l3wi/IWR-AOP-MODULE/manufacturing/jlcpcb/bom-source.csv

Comment | Designator | Footprint | LCSC | Qty | MPN | Manufacturer | Tolerance | Rating
0R | R314,R604 | Resistor_SMD:R_0402_1005Metric | C17168 | 2 | 0402WGF0000TCE | UNI-ROYAL(Uniroyal Elec)
18pF | C346,C347 | Capacitor_SMD:C_0402_1005Metric | C1549 | 2 | 0402CG180J500NT | FH (Guangdong Fenghua Advanced Tech)
390pF | C614,C615,C616,C617 | Capacitor_SMD:C_0402_1005Metric | C76967 | 4 | GRM1555C1H391JA01D | Murata Electronics | 5% | C0G 50V
47nF | C345 | Capacitor_SMD:C_0402_1005Metric | C77017 | 1 | GRM155R71E473KA88D | Murata
100nF | C301,C302,C303,C304,C305,C306,C307,C308,C309,C310,C311,C314,C315,C316,C317,C318,C319,C322,C323,C324,C325,C326,C327,C328,C329,C330,C331,C332,C333,C335,C336,C338,C340,C342,C343,C344,C348,C604,C622,C623,C706 | Capacitor_SMD:C_0402_1005Metric | C1525 | 41 | CL05B104KO5NNNC | Samsung Electro-Mechanics
0.47uH | L600,L601,L602,L603 | Inductor_SMD:L_Sunlord_MWSA0402S | C6331050 | 4 | MWSA0402S-R47MT | Sunlord
1uF | C313,C321,C337,C339 | Capacitor_SMD:C_0603_1608Metric | C15849 | 4 | CL10A105KB8NNNC | Samsung Electro-Mechanics
4.7uF | C341 | Capacitor_SMD:C_0603_1608Metric | C19666 | 1 | CL10A475KO8NNNC | Samsung Electro-Mechanics
10uF | C300,C312,C320,C334 | Capacitor_SMD:C_0805_2012Metric | C15850 | 4 | CL21A106KAYNNNE | Samsung Electro-Mechanics
10uF | C620,C621,C629 | Capacitor_SMD:C_0805_2012Metric | C86038 | 3 | GRM21BR71A106KE51L | Murata Electronics | 10% | X7R 10V
22uF | C600,C601,C602,C603,C610,C611,C612,C613 | Capacitor_SMD:C_1210_3225Metric | C21397 | 8 | GRM32ER71E226KE15L | Murata Electronics | 10% | X7R 25V
22uF | C624,C625 | Capacitor_SMD:C_0805_2012Metric | C45783 | 2 | CL21A226MAQNNNE | Samsung Electro-Mechanics | 20% | X5R 25V
1kR | R208,R410,R417 | Resistor_SMD:R_0402_1005Metric | C11702 | 3 | 0402WGF1001TCE | UNI-ROYAL(Uniroyal Elec)
3.9R | R610,R611,R612,R613 | Resistor_SMD:R_0603_1608Metric | C482845 | 4 | RC0603FR-073R9L | YAGEO | 1% | 100mW
4.7kR | R202 | Resistor_SMD:R_0402_1005Metric | C25900 | 1 | 0402WGF4701TCE | UNI-ROYAL(Uniroyal Elec)
10kR | R133,R300,R304,R305,R306,R307,R308,R309,R310,R311,R312,R313,R404,R413,R416,R600,R601,R602,R603 | Resistor_SMD:R_0402_1005Metric | C25744 | 19 | 0402WGF1002TCE | UNI-ROYAL(Uniroyal Elec)
22R | R407,R408,R409,R415 | Resistor_SMD:R_0402_1005Metric | C25092 | 4 | 0402WGF220JTCE | UNI-ROYAL(Uniroyal Elec)
24kR | R200 | Resistor_SMD:R_0402_1005Metric | C25769 | 1 | 0402WGF2402TCE | UNI-ROYAL(Uniroyal Elec)
47kR | R201 | Resistor_SMD:R_0402_1005Metric | C25792 | 1 | 0402WGF4702TCE | UNI-ROYAL(Uniroyal Elec)
100R | R209 | Resistor_SMD:R_0402_1005Metric | C25076 | 1 | 0402WGF1000TCE | UNI-ROYAL(Uniroyal Elec)
100kR | R205,R206,R402,R403,R414 | Resistor_SMD:R_0402_1005Metric | C25741 | 5 | 0402WGF1003TCE | UNI-ROYAL(Uniroyal Elec)
40MHz | Y300 | Crystal:Crystal_SMD_3225-4Pin_3.2x2.5mm | C18214314 | 1 | XL2EL89COI-111YLC-40M | YXC Crystal Oscillators
100nF 16V | C201 | Capacitor_SMD:C_0402_1005Metric | C1525 | 1 | CL05B104KO5NNNC | Samsung Electro-Mechanics
10uF 10V | C140 | Capacitor_SMD:C_0805_2012Metric | C86038 | 1 | GRM21BR71A106KE51L | Murata Electronics
120R@100MHz / 3A | FB600,FB601 | Inductor_SMD:L_0603_1608Metric | C437404 | 2 | BLM18KG121TH1D | Murata
1uF 25V | C100,C202 | Capacitor_SMD:C_0805_2012Metric | C28323 | 2 | CL21B105KBFNNNE | Samsung Electro-Mechanics
3A 32V 0467003.NRHF | F200 | Fuse:Fuse_0603_1608Metric | C99558 | 1 | 0467003.NRHF | Littelfuse
4.7uF 16V | C200,C203 | Capacitor_SMD:C_0805_2012Metric | C1779 | 2 | CL21A475KAQNNNE | Samsung Electro-Mechanics
5.1kR 1% | R100,R101 | Resistor_SMD:R_0402_1005Metric | C25905 | 2 | 0402WGF5101TCE | UNI-ROYAL(Uniroyal Elec)
BOOT | SW401 | IWR-AOP-MODULE:XKB_TS-1187A-B-A-B_5.1x5.1mm | C318884 | 1 | TS-1187A-B-A-B | XKB Connection
CP2105-F01-GMR | U200 | Package_DFN_QFN:QFN-24-1EP_4x4mm_P0.5mm_EP2.7x2.6mm | C109102 | 1 | CP2105-F01-GMR | Silicon Laboratories
H5VUT2U | D200,D201 | Package_TO_SOT_SMD:SOT-23 | C20615824 | 2 | H5VUT2U | hongjiacheng
IWR6843ARQGALPR | U300 | IWR-AOP-MODULE:BGA180C80P18X18_1500X1500X97N | C2871887 | 1 | IWR6843ARQGALPR | Texas Instruments
LM66200DRLR | U117 | Package_TO_SOT_SMD:SOT-583-8 | C3235556 | 1 | LM66200DRLR | Texas Instruments
LP87524JRNFRQ1 | U600 | IWR-AOP-MODULE:Texas_RNF0026C_LP87524J | C701982 | 1 | LP87524JRNFRQ1 | Texas Instruments
MMBT3904 | Q402 | Package_TO_SOT_SMD:SOT-23 | C20526 | 1 | MMBT3904 | Jiangsu Changjing Electronics Technology Co., Ltd.
MX25L3233FM2I-08G | U301 | Package_SO:SOIC-8_5.3x5.3mm_P1.27mm | C190802 | 1 | MX25L3233FM2I-08G | Macronix
RADAR JTAG | J301 | IWR-AOP-MODULE:XKB_X1270WVS-2x05B-9TV01_2x05_P1.27mm_Vertical | C2962219 | 1 | X1270WVS-2x05B-9TV01 | XKB Connection
RESET | SW400 | IWR-AOP-MODULE:XKB_TS-1187A-B-A-B_5.1x5.1mm | C318884 | 1 | TS-1187A-B-A-B | XKB Connection
SPI / DATA | J401 | IWR-AOP-MODULE:HCTL_PM254-2-05-S-8.5 | C3975150 | 1 | PM254-2-05-S-8.5 | HCTL
UART / CONTROL / 5V IN | J400 | IWR-AOP-MODULE:HCTL_PM254-2-06-S-8.5 | C3975151 | 1 | PM254-2-06-S-8.5 | HCTL
USB4105-GF-A | J200 | Connector_USB:USB_C_Receptacle_GCT_USB4105-xx-A_16P_TopMnt_Horizontal | C3020560 | 1 | USB4105-GF-A | Global Connector Technology
