l3wi/IWR-AOP-MODULE/docs/3d/IWR-AOP-MODULE.step

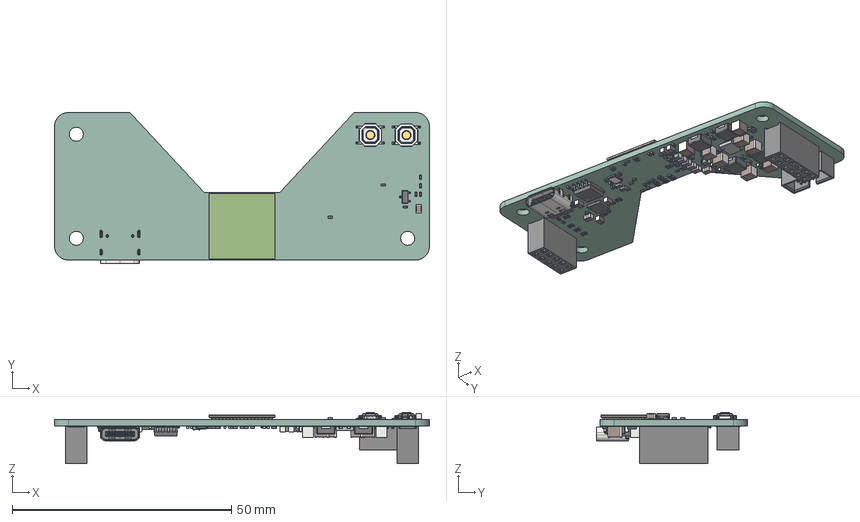
[picture p4: CAD file, 2026-10-05]
docs/3d/IWR-AOP-MODULE.step
85.6 x 34.5 x 11.7 mm
R_0402_1005Metric x 39
SW-SMD_4P-L5.1-W5.1-P3.70-LS6.5-TL_H1.5 x 2
SOT-23 x 3
C_0805_2012Metric x 14
FCCSP_CORE_AF0
FCCSP_SOLDER_BALL x 180
FCCSP_SOLDER_BALL_AF57
FCCSP_SOLDER_BALL_AF58
FCCSP_SOLDER_BALL_AF59
FCCSP_SOLDER_BALL_AF60
FCCSP_SOLDER_BALL_AF61
FCCSP_SOLDER_BALL_AF62
FCCSP_SOLDER_BALL_AF63
FCCSP_SOLDER_BALL_AF64
FCCSP_SOLDER_BALL_AF65
FCCSP_SOLDER_BALL_AF66
FCCSP_SOLDER_BALL_AF67
FCCSP_SOLDER_BALL_AF68
FCCSP_SOLDER_BALL_AF69
FCCSP_SOLDER_BALL_AF70
FCCSP_SOLDER_BALL_AF71
FCCSP_SOLDER_BALL_AF72
FCCSP_SOLDER_BALL_AF73
FCCSP_SOLDER_BALL_AF74
FCCSP_SOLDER_BALL_AF75
FCCSP_SOLDER_BALL_AF76
FCCSP_SOLDER_BALL_AF77
FCCSP_SOLDER_BALL_AF78
FCCSP_SOLDER_BALL_AF79
FCCSP_SOLDER_BALL_AF80
FCCSP_SOLDER_BALL_AF81
FCCSP_SOLDER_BALL_AF82
FCCSP_SOLDER_BALL_AF83
FCCSP_SOLDER_BALL_AF84
FCCSP_SOLDER_BALL_AF85
FCCSP_SOLDER_BALL_AF86
FCCSP_SOLDER_BALL_AF87
FCCSP_SOLDER_BALL_AF88
FCCSP_SOLDER_BALL_AF89
FCCSP_SOLDER_BALL_AF90
FCCSP_SOLDER_BALL_AF91
FCCSP_SOLDER_BALL_AF92
FCCSP_SOLDER_BALL_AF93
FCCSP_SOLDER_BALL_AF94
FCCSP_SOLDER_BALL_AF95
FCCSP_SOLDER_BALL_AF25
FCCSP_SOLDER_BALL_AF26
FCCSP_SOLDER_BALL_AF27
FCCSP_SOLDER_BALL_AF28
FCCSP_SOLDER_BALL_AF29
FCCSP_SOLDER_BALL_AF30
FCCSP_SOLDER_BALL_AF96
FCCSP_SOLDER_BALL_AF97
FCCSP_SOLDER_BALL_AF98
FCCSP_SOLDER_BALL_AF99
FCCSP_SOLDER_BALL_AF100
FCCSP_SOLDER_BALL_AF101
FCCSP_SOLDER_BALL_AF31
FCCSP_SOLDER_BALL_AF32
FCCSP_SOLDER_BALL_AF33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
