l3wi/IWR-AOP-MODULE/CHANGELOG.md

# Changelog

All notable changes are documented here, following [Keep a Changelog](https://keepachangelog.com/en/1.1.0/).

## [1.0] - 2026-10-05

### Added

- First public release of the IWR6843AOP 60 GHz mmWave radar module: 85.6 × 33.7 mm, six layers, antenna-on-package and on-board QSPI boot flash. In production.
- USB-C power and CP2105 dual UART, plus 5 V carrier operation with UART, SPI, control and synchronization signals.
- Ideal-diode input OR, four-rail LP87524J-Q1 PMIC and reset sequencing; BOOT/RESET buttons, Cortex-10 JTAG, debug-boot jumper and rail/control test pads.
- KiCad 10 project, project symbol/footprint/3D libraries, JLCPCB manufacturing package, hardware specification and BOM cost reference.
- Product renders, looping GIF and orbit video, pinout and dimension drawings, and reproducible drawing/render tools.
