l3wi/IWR-AOP-MODULE/IWR-AOP-MODULE.kicad_pcb

## KiCad design IWR-AOP-MODULE.kicad_pcb (2026-10-05)

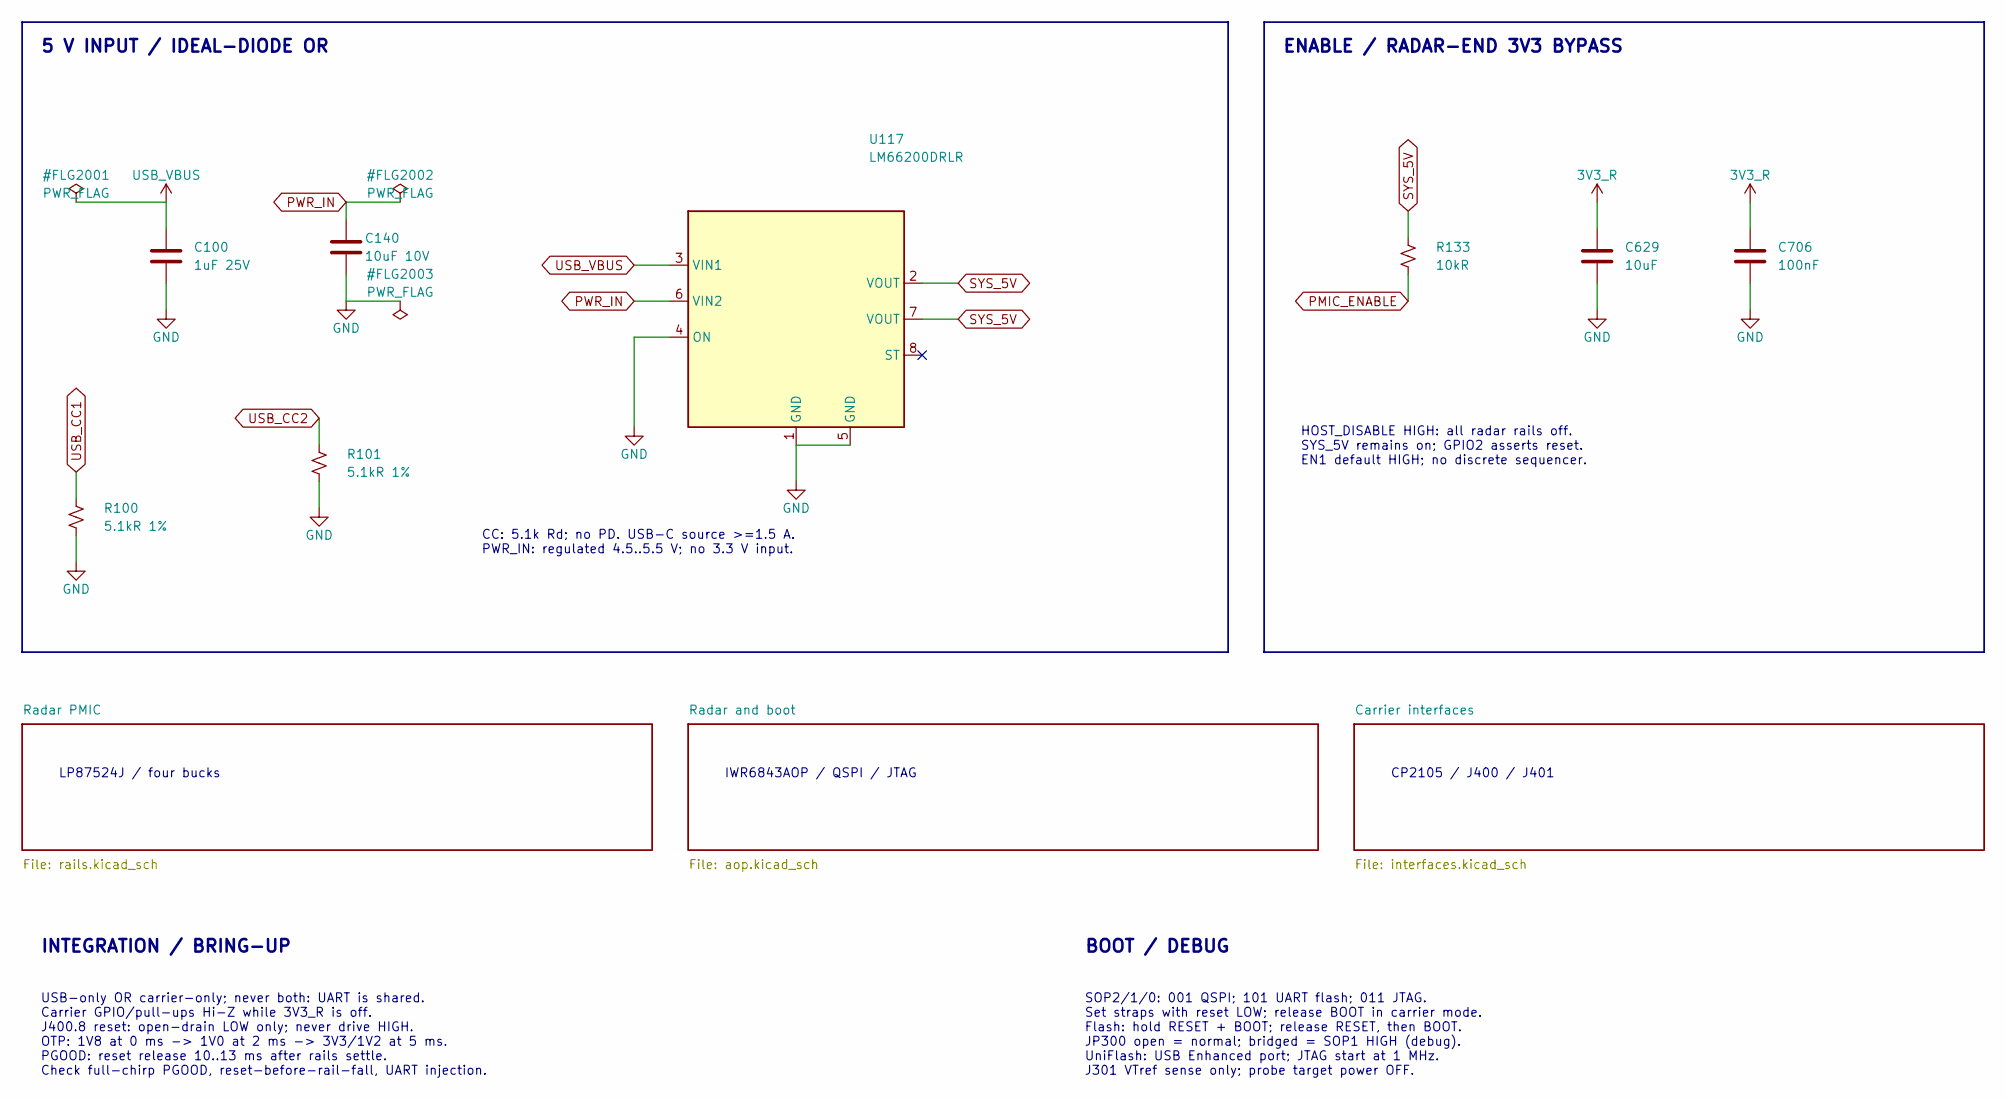
[picture p5: schematic IWR-AOP-MODULE.kicad_sch, IWR-AOP-MODULE / Power entry and integration]

Parts:
C100: 1uF 25V; C_0805_2012Metric; MPN CL21B105KBFNNNE; LCSC C28323
C140: 10uF 10V; C_0805_2012Metric; MPN GRM21BR71A106KE51L; LCSC C86038
C629: 10uF; C_0805_2012Metric; Tolerance 10%; Rating X7R 10V; MPN GRM21BR71A106KE51L; LCSC C86038
C706: 100nF; C_0402_1005Metric; MPN CL05B104KO5NNNC; LCSC C1525
R100, R101: 5.1kR 1%; R_0402_1005Metric; MPN 0402WGF5101TCE; LCSC C25905
R133: 10kR; R_0402_1005Metric; MPN 0402WGF1002TCE; LCSC C25744
U117: LM66200DRLR; SOT-583-8; MPN LM66200DRLR; LCSC C3235556

Connections:
3V3_R: C629.1, C706.1; also elsewhere on the board
GND: C100.2, C140.2, C629.2, C706.2, R100.2, R101.2, U117.1 (GND), U117.4 (ON), U117.5 (GND); also elsewhere on the board
PMIC_ENABLE: R133.2; also elsewhere on the board
PWR_IN: C140.1, U117.6 (VIN2); also elsewhere on the board
SYS_5V: R133.1, U117.2 (VOUT), U117.7 (VOUT); also elsewhere on the board
USB_CC1: R100.1; also elsewhere on the board
USB_CC2: R101.1; also elsewhere on the board
USB_VBUS: C100.1, U117.3 (VIN1); also elsewhere on the board

Notes on the sheet:
5 V INPUT / IDEAL-DIODE OR
CC: 5.1k Rd; no PD. USB-C source >=1.5 A. PWR_IN: regulated 4.5..5.5 V; no 3.3 V input.
ENABLE / RADAR-END 3V3 BYPASS
HOST_DISABLE HIGH: all radar rails off. SYS_5V remains on; GPIO2 asserts reset. EN1 default HIGH; no discrete sequencer.
LP87524J / four bucks
IWR6843AOP / QSPI / JTAG
CP2105 / J400 / J401
INTEGRATION / BRING-UP
USB-only OR carrier-only; never both: UART is shared. Carrier GPIO/pull-ups Hi-Z while 3V3_R is off. J400.8 reset: open-drain LOW only; never drive HIGH. OTP: 1V8 at 0 ms -> 1V0 at 2 ms -> 3V3/1V2 at 5 ms. PGOOD: reset release 10..13 ms after rails settle. Check full-chirp PGOOD, reset-before-rail-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
BOOT / DEBUG
SOP2/1/0: 001 QSPI; 101 UART flash; 011 JTAG. Set straps with reset LOW; release BOOT in carrier mode. Flash: hold RESET + BOOT; release RESET, then BOOT. JP300 open = normal; bridged = SOP1 HIGH (debug). UniFlash: USB Enhanced port; JTAG start at 1 MHz. J301 VTref sense only; probe target power OF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

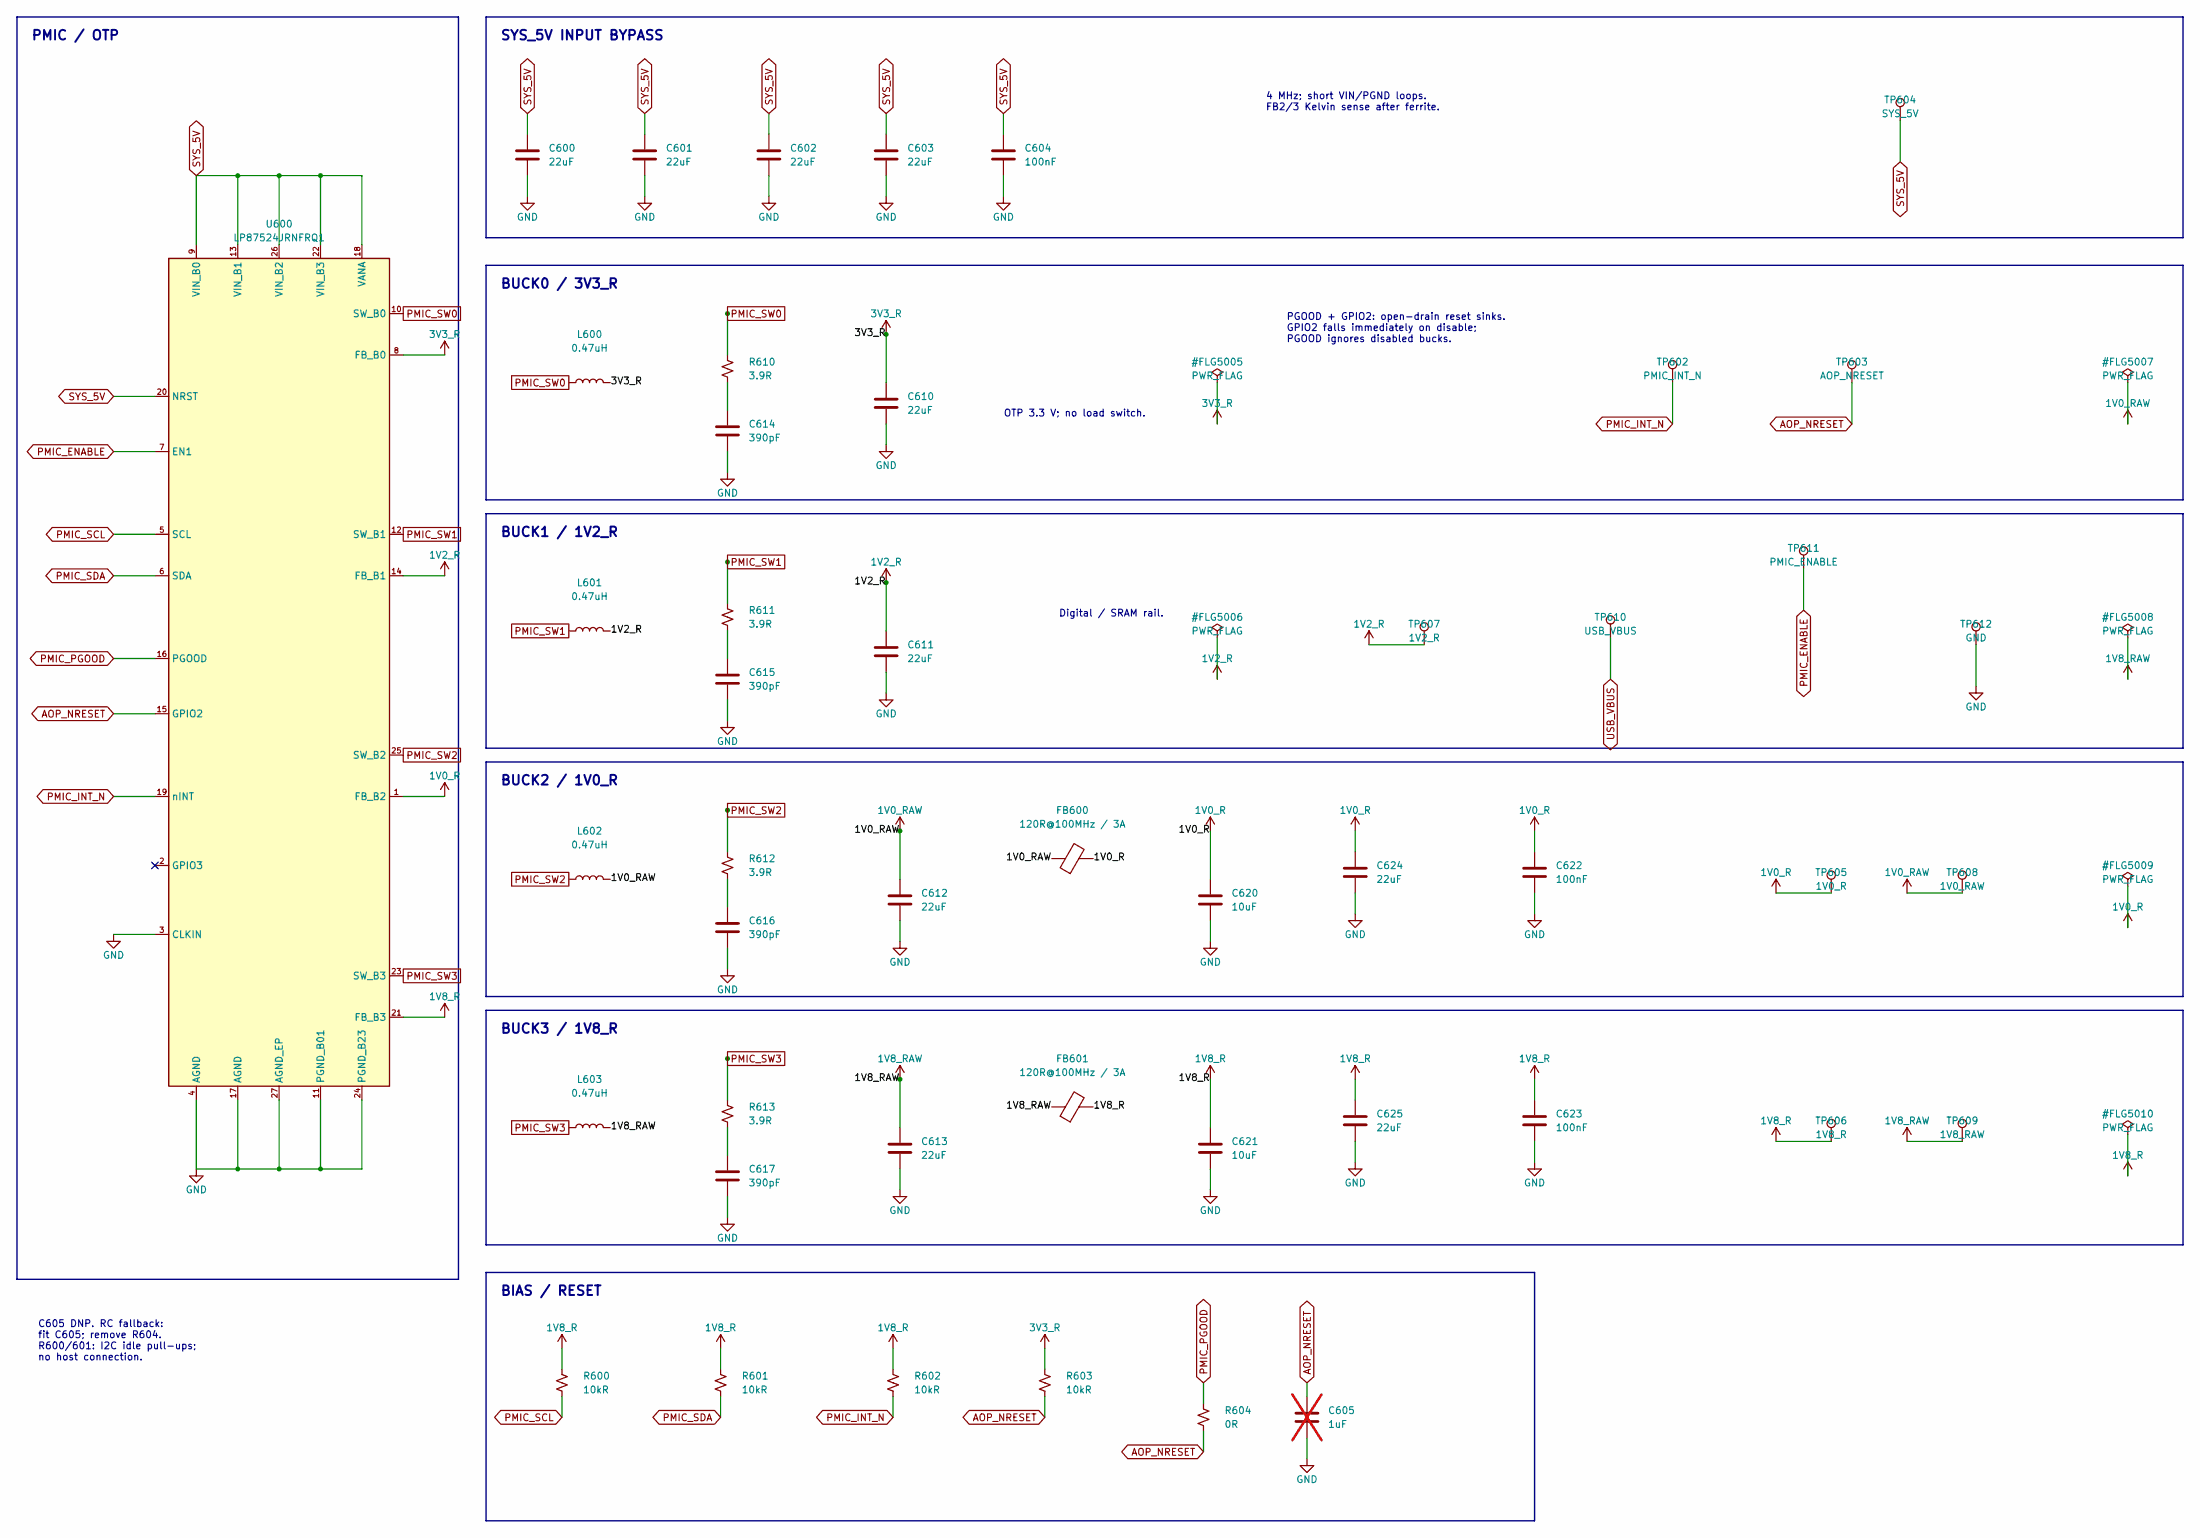
[picture p6: schematic rails.kicad_sch, IWR-AOP-MODULE / PMIC rails and reset]

Parts:
C600, C601, C602, C603, C610, C611, C612, C613: 22uF; C_1210_3225Metric; Rating X7R 25V; Tolerance 10%; MPN GRM32ER71E226KE15L; LCSC C21397
C604, C622, C623: 100nF; C_0402_1005Metric; MPN CL05B104KO5NNNC; LCSC C1525
C605: 1uF; C_0603_1608Metric; MPN CL10A105KB8NNNC; LCSC C15849; not fitted
C614, C615, C616, C617: 390pF; C_0402_1005Metric; Tolerance 5%; Rating C0G 50V; MPN GRM1555C1H391JA01D; LCSC C76967
C620, C621: 10uF; C_0805_2012Metric; Tolerance 10%; Rating X7R 10V; MPN GRM21BR71A106KE51L; LCSC C86038
C624, C625: 22uF; C_0805_2012Metric; Rating X5R 25V; Tolerance 20%; MPN CL21A226MAQNNNE; LCSC C45783
FB600, FB601: 120R@100MHz / 3A; L_0603_1608Metric; MPN BLM18KG121TH1D; LCSC C437404
L600, L601, L602, L603: 0.47uH; L_Sunlord_MWSA0402S; MPN MWSA0402S-R47MT; LCSC C6331050
R600, R601, R602, R603: 10kR; R_0402_1005Metric; MPN 0402WGF1002TCE; LCSC C25744
R604: 0R; R_0402_1005Metric; MPN 0402WGF0000TCE; LCSC C17168
R610, R611, R612, R613: 3.9R; R_0603_1608Metric; Tolerance 1%; Rating 100mW; MPN RC0603FR-073R9L; LCSC C482845
TP602: PMIC_INT_N; TestPoint_Pad_D1.0mm; MPN PCB_TEST_PAD_1MM
TP603: AOP_NRESET; TestPoint_Pad_D1.0mm; MPN PCB_TEST_PAD_1MM
TP604: SYS_5V; TestPoint_Pad_D1.0mm; MPN PCB_TEST_PAD_1MM
TP605: 1V0_R; TestPoint_Pad_D1.0mm; MPN PCB_TEST_PAD_1MM
TP606: 1V8_R; TestPoint_Pad_D1.0mm; MPN PCB_TEST_PAD_1MM
TP607: 1V2_R; TestPoint_Pad_D1.0mm; MPN PCB_TEST_PAD_1MM
TP608: 1V0_RAW; TestPoint_Pad_D1.0mm; MPN PCB_TEST_PAD_1MM
TP609: 1V8_RAW; TestPoint_Pad_D1.0mm; MPN PCB_TEST_PAD_1MM
TP610: USB_VBUS; TestPoint_Pad_D1.0mm; MPN PCB_TEST_PAD_1MM
TP611: PMIC_ENABLE; TestPoint_Pad_D1.0mm; MPN PCB_TEST_PAD_1MM
TP612: GND; TestPoint_Pad_D1.0mm; MPN PCB_TEST_PAD_1MM
U600: LP87524JRNFRQ1; Texas_RNF0026C_LP87524J; MPN LP87524JRNFRQ1; LCSC C701982

Connections:
1V0_R: C620.1, C622.1, C624.1, FB600.2, TP605.1, U600.1 (FB_B2); also elsewhere on the board
1V0_RAW: C612.1, FB600.1, L602.2, TP608.1
1V2_R: C611.1, L601.2, TP607.1, U600.14 (FB_B1); also elsewhere on the board
1V8_R: C621.1, C623.1, C625.1, FB601.2, R600.1, R601.1, R602.1, TP606.1, U600.21 (FB_B3); also elsewhere on the board
1V8_RAW: C613.1, FB601.1, L603.2, TP609.1
3V3_R: C610.1, L600.2, R603.1, U600.8 (FB_B0); also elsewhere on the board
AOP_NRESET: C605.1, R603.2, R604.2, TP603.1 (1_1), U600.15 (GPIO2); also elsewhere on the board
GND: C600.2, C601.2, C602.2, C603.2, C604.2, C605.2, C610.2, C611.2, C612.2, C613.2, C614.2, C615.2, C616.2, C617.2, C620.2, C621.2, C622.2, C623.2, C624.2, C625.2, TP612.1, U600.3 (CLKIN), U600.4 (AGND), U600.11 (PGND_B01), U600.17 (AGND), U600.24 (PGND_B23), U600.27 (AGND_EP); also elsewhere on the board
unnamed: C614.1, R610.2
unnamed: C615.1, R611.2
unnamed: C616.1, R612.2
unnamed: C617.1, R613.2
PMIC_ENABLE: TP611.1, U600.7 (EN1); also elsewhere on the board
PMIC_INT_N: R602.2, TP602.1 (1_1), U600.19 (nINT)
PMIC_PGOOD: R604.1, U600.16 (PGOOD)
PMIC_SCL: R600.2, U600.5 (SCL)
PMIC_SDA: R601.2, U600.6 (SDA)
PMIC_SW0: L600.1, R610.1, U600.10 (SW_B0)
PMIC_SW1: L601.1, R611.1, U600.12 (SW_B1)
PMIC_SW2: L602.1, R612.1, U600.25 (SW_B2)
PMIC_SW3: L603.1, R613.1, U600.23 (SW_B3)
SYS_5V: C600.1, C601.1, C602.1, C603.1, C604.1, TP604.1, U600.9 (VIN_B0), U600.13 (VIN_B1), U600.18 (VANA), U600.20 (NRST), U600.22 (VIN_B3), U600.26 (VIN_B2); also elsewhere on the board
USB_VBUS: TP610.1; also elsewhere on the board

Notes on the sheet:
PMIC / OTP
SYS_5V INPUT BYPASS
4 MHz; short VIN/PGND loops. FB2/3 Kelvin sense after ferrite.
BUCK0 / 3V3_R
OTP 3.3 V; no load switch.
BUCK1 / 1V2_R
Digital / SRAM rail.
BUCK2 / 1V0_R
BUCK3 / 1V8_R
BIAS / RESET
C605 DNP. RC fallback: fit C605; remove R604. R600/601: I2C idle pull-ups; no host connection.
PGOOD + GPIO2: open-drain reset sinks. GPIO2 falls immediately on disable; PGOOD ignores disabled bucks.

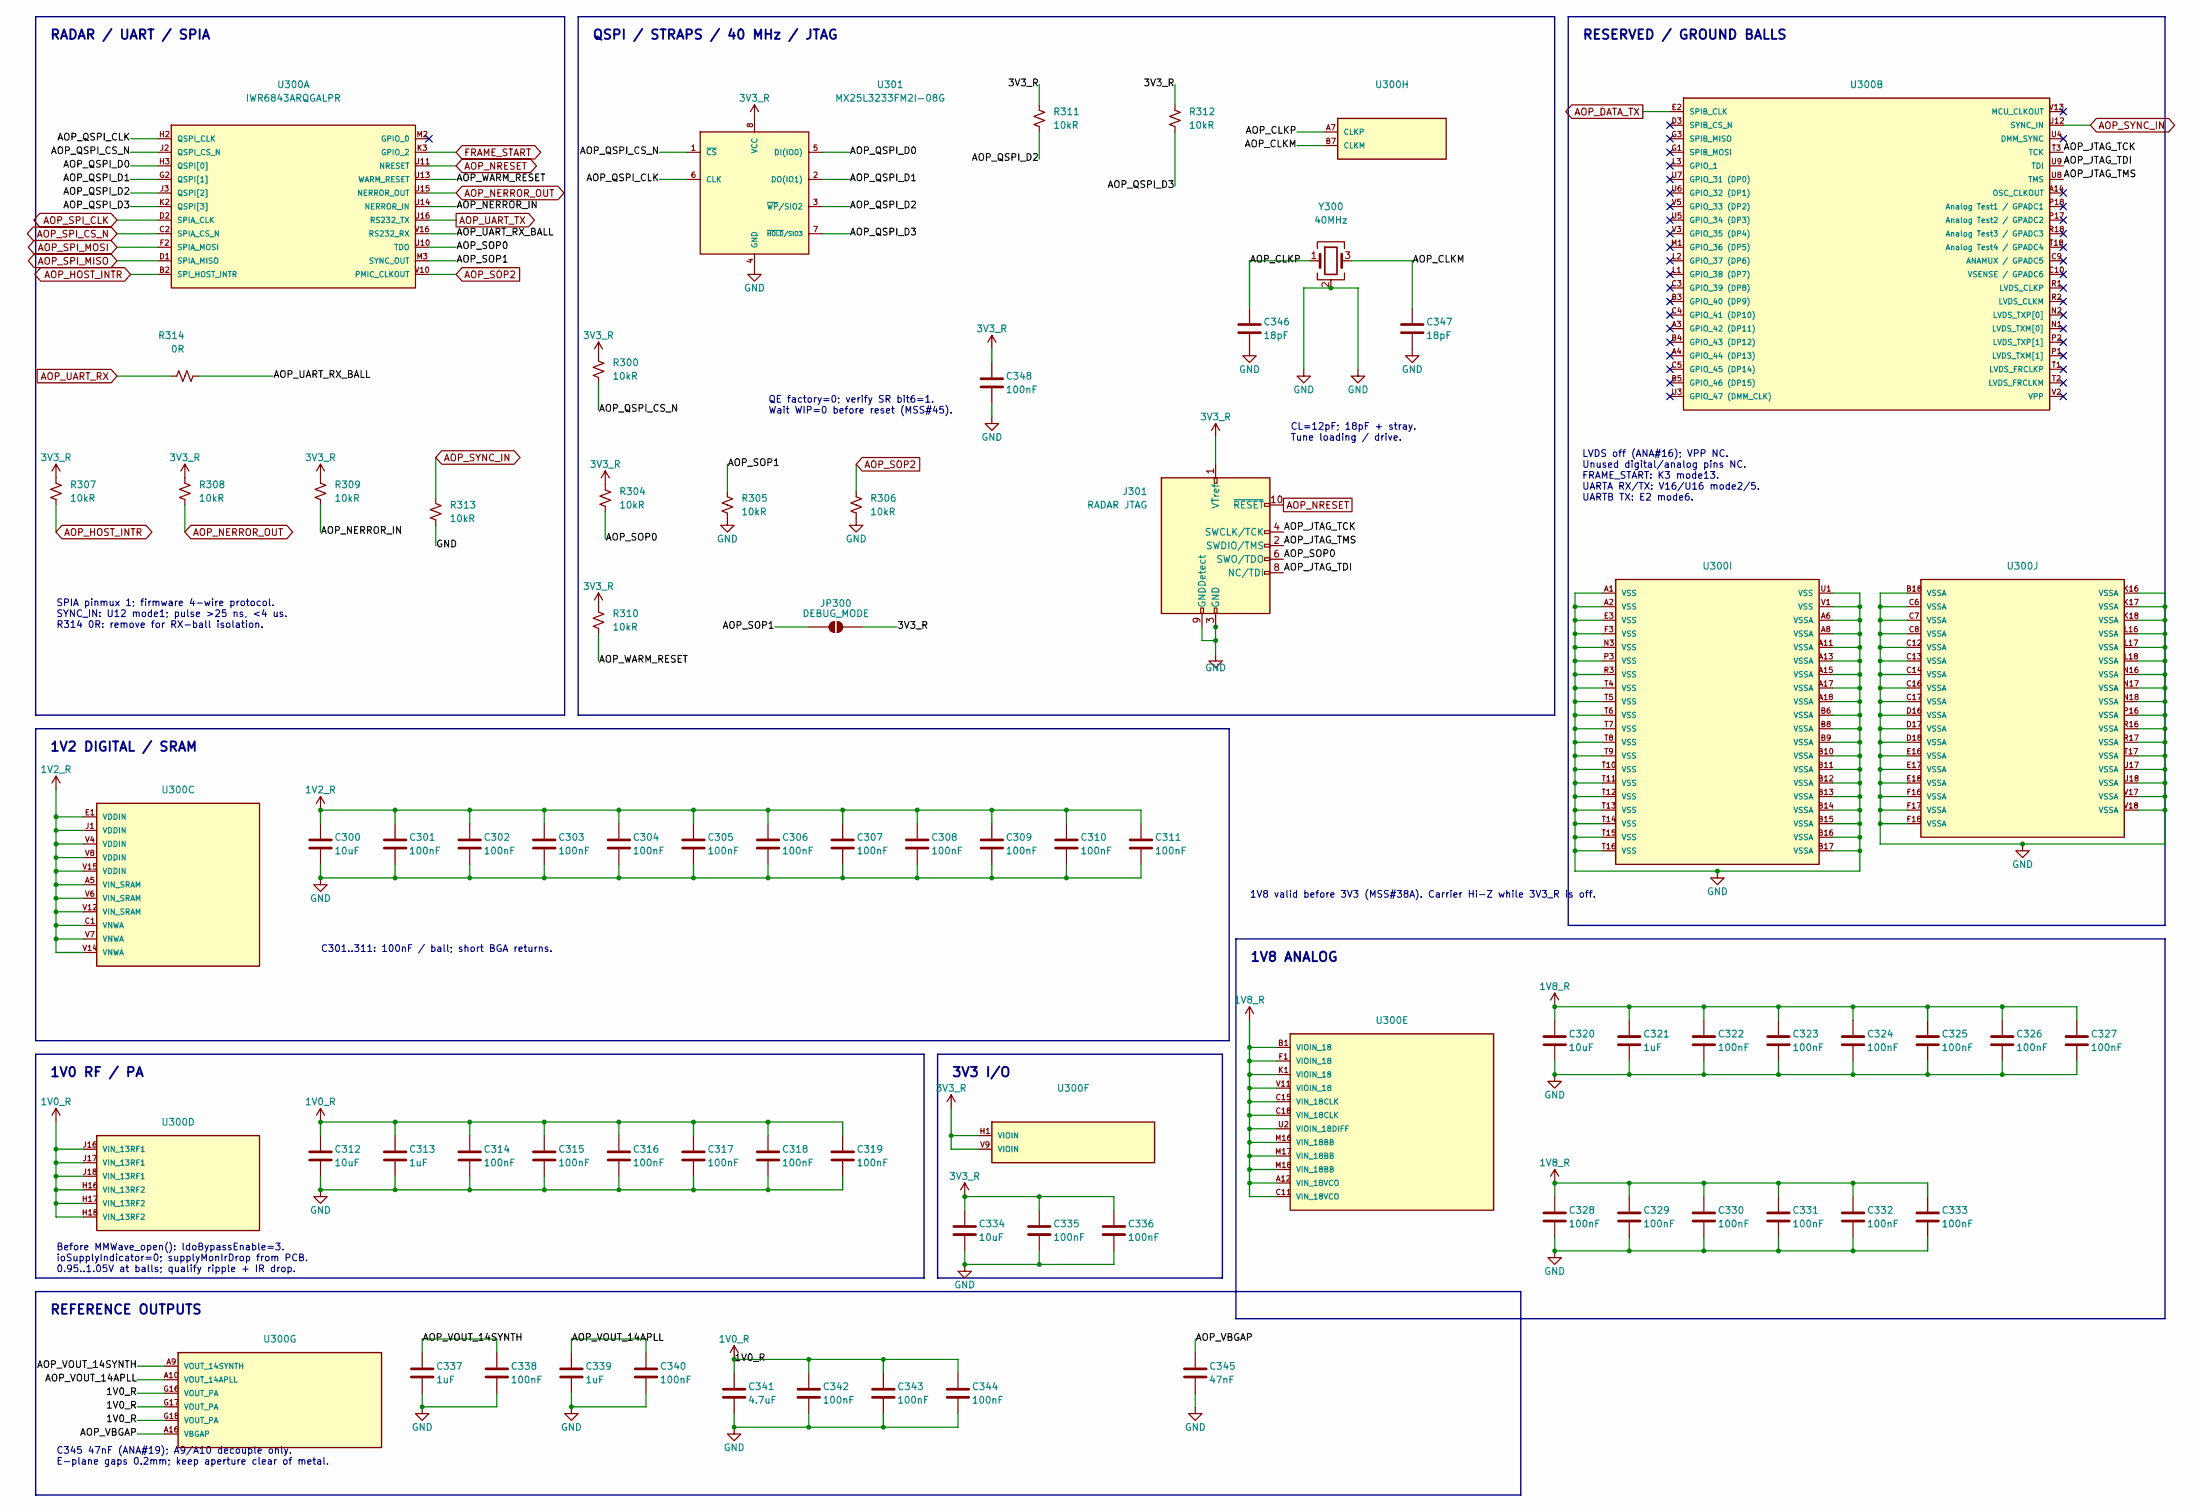
[picture p7: schematic aop.kicad_sch, IWR-AOP-MODULE / Radar and boot]

Parts:
C300, C312, C320, C334: 10uF; C_0805_2012Metric; MPN CL21A106KAYNNNE; LCSC C15850
C301, C302, C303, C304, C305, C306, C307, C308, C309, C310, C311, C314, C315, C316, C317, C318, C319, C322, C323, C324, C325, C326, C327, C328, C329, C330, C331, C332, C333, C335, C336, C338, C340, C342, C343, C344, C348: 100nF; C_0402_1005Metric; MPN CL05B104KO5NNNC; LCSC C1525
C313, C321, C337, C339: 1uF; C_0603_1608Metric; MPN CL10A105KB8NNNC; LCSC C15849
C341: 4.7uF; C_0603_1608Metric; MPN CL10A475KO8NNNC; LCSC C19666
C345: 47nF; C_0402_1005Metric; MPN GRM155R71E473KA88D; LCSC C77017
C346, C347: 18pF; C_0402_1005Metric; MPN 0402CG180J500NT; LCSC C1549
J301: RADAR JTAG; XKB_X1270WVS-2x05B-9TV01_2x05_P1.27mm_Vertical; MPN X1270WVS-2x05B-9TV01; LCSC C2962219
JP300: DEBUG_MODE; SolderJumper-2_P1.3mm_Open_RoundedPad1.0x1.5mm
R300, R304, R305, R306, R307, R308, R309, R310, R311, R312, R313: 10kR; R_0402_1005Metric; MPN 0402WGF1002TCE; LCSC C25744
R314: 0R; R_0402_1005Metric; MPN 0402WGF0000TCE; LCSC C17168
U300: IWR6843ARQGALPR; BGA180C80P18X18_1500X1500X97N; MPN IWR6843ARQGALPR; LCSC C2871887
U301: MX25L3233FM2I-08G; SOIC-8_5.3x5.3mm_P1.27mm; MPN MX25L3233FM2I-08G; LCSC C190802
Y300: 40MHz; Crystal_SMD_3225-4Pin_3.2x2.5mm; MPN XL2EL89COI-111YLC-40M; LCSC C18214314

Connections:
1V0_R: C312.1, C313.1, C314.1, C315.1, C316.1, C317.1, C318.1, C319.1, C341.1, C342.1, C343.1, C344.1, U300.G16 (VOUT_PA), U300.G17 (VOUT_PA), U300.G18 (VOUT_PA), U300.H16 (VIN_13RF2), U300.H17 (VIN_13RF2), U300.H18 (VIN_13RF2), U300.J16 (VIN_13RF1), U300.J17 (VIN_13RF1), U300.J18 (VIN_13RF1); also elsewhere on the board
1V2_R: C300.1, C301.1, C302.1, C303.1, C304.1, C305.1, C306.1, C307.1, C308.1, C309.1, C310.1, C311.1, U300.A5 (VIN_SRAM), U300.C1 (VNWA), U300.E1 (VDDIN), U300.J1 (VDDIN), U300.V4 (VDDIN), U300.V6 (VIN_SRAM), U300.V7 (VNWA), U300.V8 (VDDIN), U300.V12 (VIN_SRAM), U300.V14 (VNWA), U300.V15 (VDDIN); also elsewhere on the board
1V8_R: C320.1, C321.1, C322.1, C323.1, C324.1, C325.1, C326.1, C327.1, C328.1, C329.1, C330.1, C331.1, C332.1, C333.1, U300.A12 (VIN_18VCO), U300.B1 (VIOIN_18), U300.C11 (VIN_18VCO), U300.C15 (VIN_18CLK), U300.C18 (VIN_18CLK), U300.F1 (VIOIN_18), U300.K1 (VIOIN_18), U300.M16 (VIN_18BB), U300.M17 (VIN_18BB), U300.M18 (VIN_18BB), U300.U2 (VIOIN_18DIFF), U300.V11 (VIOIN_18); also elsewhere on the board
3V3_R: C334.1, C335.1, C336.1, C348.1, J301.1 (VTref), JP300.2 (B), R300.1, R304.1, R307.1, R308.1, R309.1, R310.1, R311.1, R312.1, U300.H1 (VIOIN), U300.V9 (VIOIN), U301.8 (VCC); also elsewhere on the board
/Radar and boot/AOP_CLKM: C347.1, U300.B7 (CLKM), Y300.3
/Radar and boot/AOP_CLKP: C346.1, U300.A7 (CLKP), Y300.1
/Radar and boot/AOP_JTAG_TCK: J301.4 (SWCLK/TCK), U300.T3 (TCK)
/Radar and boot/AOP_JTAG_TDI: J301.8 (NC/TDI), U300.U9 (TDI)
/Radar and boot/AOP_JTAG_TMS: J301.2 (SWDIO/TMS), U300.U8 (TMS)
/Radar and boot/AOP_NERROR_IN: R309.2, U300.U14 (NERROR_IN)
/Radar and boot/AOP_QSPI_CLK: U300.H2 (QSPI_CLK), U301.6 (CLK)
/Radar and boot/AOP_QSPI_CS_N: R300.2, U300.J2 (QSPI_CS_N), U301.1 (~CS)
/Radar and boot/AOP_QSPI_D0: U300.H3 (QSPI[0]), U301.5 (DI(IO0))
/Radar and boot/AOP_QSPI_D1: U300.G2 (QSPI[1]), U301.2 (DO(IO1))
/Radar and boot/AOP_QSPI_D2: R311.2, U300.J3 (QSPI[2]), U301.3 (~WP/SIO2)
/Radar and boot/AOP_QSPI_D3: R312.2, U300.K2 (QSPI[3]), U301.7 (~HOLD/SIO3)
/Radar and boot/AOP_SOP0: J301.6 (SWO/TDO), R304.2, U300.U10 (TDO)
/Radar and boot/AOP_SOP1: JP300.1 (A), R305.1, U300.M3 (SYNC_OUT)
/Radar and boot/AOP_UART_RX_BALL: R314.2, U300.V16 (RS232_RX)
/Radar and boot/AOP_VBGAP: C345.1, U300.A16 (VBGAP)
/Radar and boot/AOP_VOUT_14APLL: C339.1, C340.1, U300.A10 (VOUT_14APLL)
/Radar and boot/AOP_VOUT_14SYNTH: C337.1, C338.1, U300.A9 (VOUT_14SYNTH)
/Radar and boot/AOP_WARM_RESET: R310.2, U300.U13 (WARM_RESET)
AOP_DATA_TX: U300.E2 (SPIB_CLK); also elsewhere on the board
AOP_HOST_INTR: R307.2, U300.B2 (SPI_HOST_INTR); also elsewhere on the board
AOP_NERROR_OUT: R308.2, U300.U15 (NERROR_OUT); also elsewhere on the board
AOP_NRESET: J301.10 (~RESET), U300.U11 (NRESET); also elsewhere on the board
AOP_SOP2: R306.1, U300.V10 (PMIC_CLKOUT); also elsewhere on the board
AOP_SPI_CLK: U300.D2 (SPIA_CLK); also elsewhere on the board
AOP_SPI_CS_N: U300.C2 (SPIA_CS_N); also elsewhere on the board
AOP_SPI_MISO: U300.D1 (SPIA_MISO); also elsewhere on the board
AOP_SPI_MOSI: U300.F2 (SPIA_MOSI); also elsewhere on the board
AOP_SYNC_IN: R313.1, U300.U12 (SYNC_IN); also elsewhere on the board
AOP_UART_RX: R314.1; also elsewhere on the board
AOP_UART_TX: U300.U16 (RS232_TX); also elsewhere on the board
FRAME_START: U300.K3 (GPIO_2); also elsewhere on the board
GND: C300.2, C301.2, C302.2, C303.2, C304.2, C305.2, C306.2, C307.2, C308.2, C309.2, C310.2, C311.2, C312.2, C313.2, C314.2, C315.2, C316.2, C317.2, C318.2, C319.2, C320.2, C321.2, C322.2, C323.2, C324.2, C325.2, C326.2, C327.2, C328.2, C329.2, C330.2, C331.2, C332.2, C333.2, C334.2, C335.2, C336.2, C337.2, C338.2, C339.2, C340.2, C341.2, C342.2, C343.2, C344.2, C345.2, C346.2, C347.2, C348.2, J301.3 (GND), J301.5 (GND), J301.9 (GNDDetect), R305.2, R306.2, R313.2, U300.A1 (VSS), U300.A2 (VSS), U300.A6 (VSSA), U300.A8 (VSSA), U300.A11 (VSSA), U300.A13 (VSSA), U300.A15 (VSSA), U300.A17 (VSSA), U300.A18 (VSSA), U300.B6 (VSSA), U300.B8 (VSSA), U300.B9 (VSSA), U300.B10 (VSSA), U300.B11 (VSSA), U300.B12 (VSSA), U300.B13 (VSSA), U300.B14 (VSSA), U300.B15 (VSSA), U300.B16 (VSSA), U300.B17 (VSSA), U300.B18 (VSSA), U300.C6 (VSSA), U300.C7 (VSSA), U300.C8 (VSSA), U300.C12 (VSSA), U300.C13 (VSSA), U300.C14 (VSSA), U300.C16 (VSSA), U300.C17 (VSSA), U300.D16 (VSSA), U300.D17 (VSSA), U300.D18 (VSSA), U300.E3 (VSS), U300.E16 (VSSA), U300.E17 (VSSA), U300.E18 (VSSA), U300.F3 (VSS), U300.F16 (VSSA), U300.F17 (VSSA), U300.F18 (VSSA), U300.K16 (VSSA), U300.K17 (VSSA), U300.K18 (VSSA), U300.L16 (VSSA), U300.L17 (VSSA), U300.L18 (VSSA), U300.N3 (VSS), U300.N16 (VSSA), U300.N17 (VSSA), U300.N18 (VSSA), U300.P3 (VSS), U300.P16 (VSSA), U300.R3 (VSS), U300.R16 (VSSA), U300.R17 (VSSA), U300.T4 (VSS), U300.T5 (VSS), U300.T6 (VSS), U300.T7 (VSS), U300.T8 (VSS), U300.T9 (VSS), U300.T10 (VSS), U300.T11 (VSS), U300.T12 (VSS), U300.T13 (VSS), U300.T14 (VSS), U300.T15 (VSS), U300.T16 (VSS), U300.T17 (VSSA), U300.U1 (VSS), U300.U17 (VSSA), U300.U18 (VSSA), U300.V1 (VSS), U300.V17 (VSSA), U300.V18 (VSSA), U301.4 (GND), Y300.2 (G), Y300.4 (G); also elsewhere on the board

Notes on the sheet:
SPIA pinmux 1; firmware 4-wire protocol. SYNC_IN: U12 mode1; pulse >25 ns, <4 us. R314 0R: remove for RX-ball isolation.
QE factory=0; verify SR bit6=1. Wait WIP=0 before reset (MSS#45).
CL=12pF; 18pF + stray. Tune loading / drive.
LVDS off (ANA#16); VPP NC. Unused digital/analog pins NC. FRAME_START: K3 mode13. UARTA RX/TX: V16/U16 mode2/5. UARTB TX: E2 mode6.
C301..311: 100nF / ball; short BGA returns.
Before MMWave_open(): ldoBypassEnable=3. ioSupplyIndicator=0; supplyMonIrDrop from PCB. 0.95..1.05V at balls; qualify ripple + IR drop.
C345 47nF (ANA#19); A9/A10 decouple only. E-plane gaps 0.2mm; keep aperture clear of metal.
RADAR / UART / SPIA
QSPI / STRAPS / 40 MHz / JTAG
RESERVED / GROUND BALLS
1V2 DIGITAL / SRAM
1V8 ANALOG
1V0 RF / PA
3V3 I/O
REFERENCE OUTPUTS
1V8 valid before 3V3 (MSS#38A). Carrier Hi-Z while 3V3_R is off.

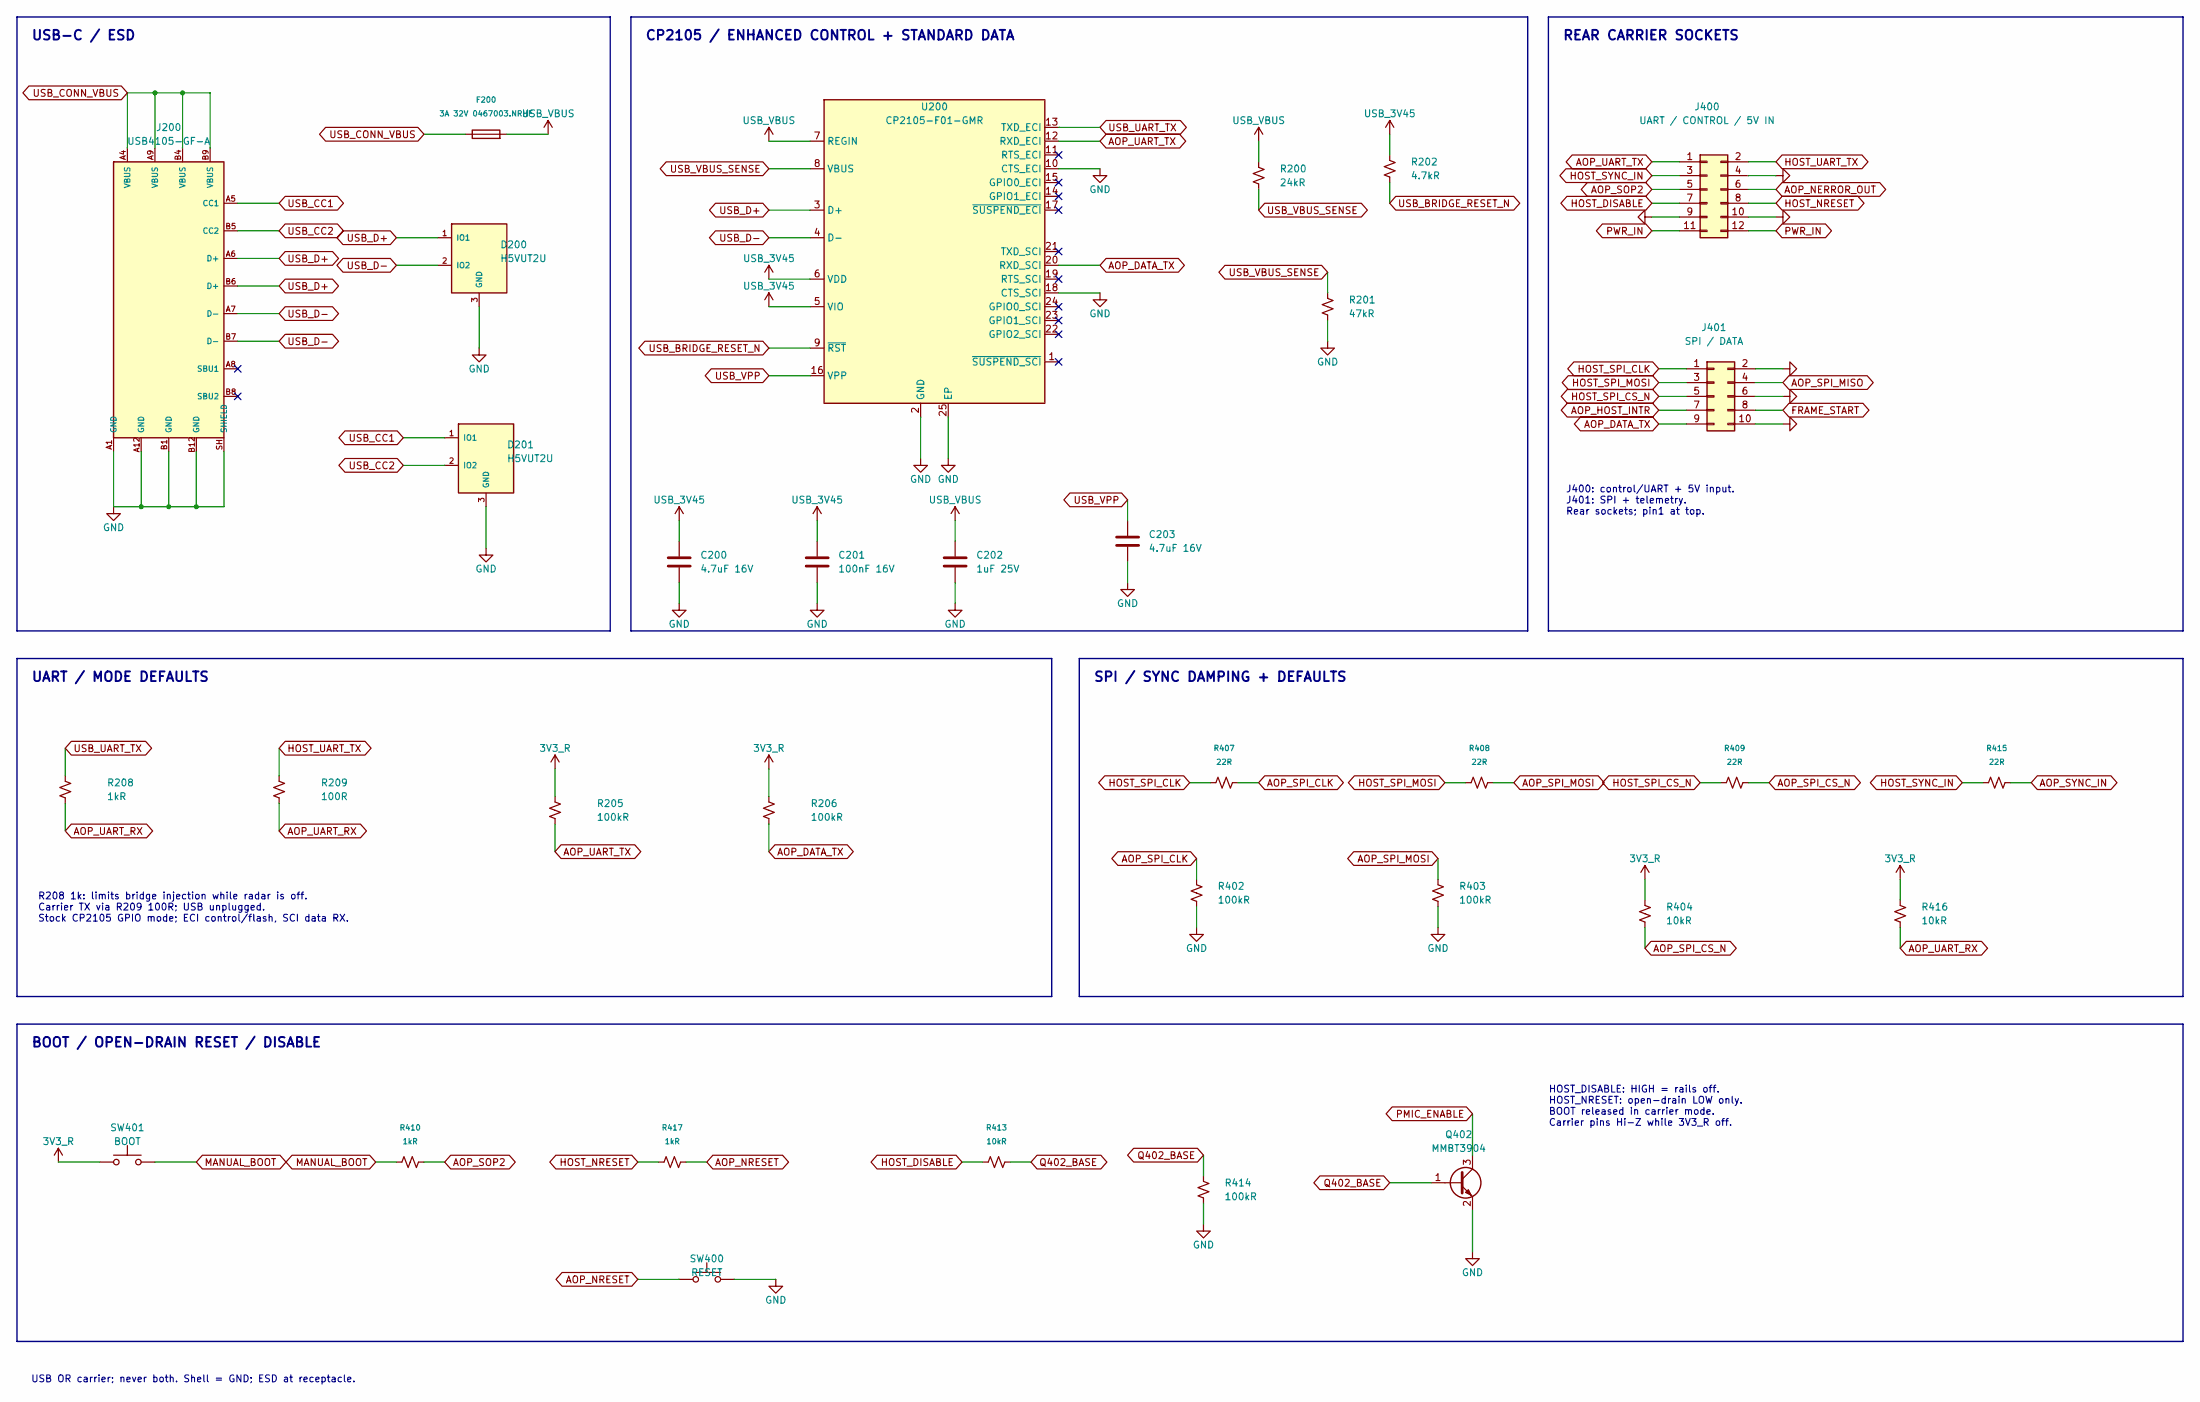
[picture p8: schematic interfaces.kicad_sch, IWR-AOP-MODULE / USB UART and carrier interfaces]

Parts:
C200, C203: 4.7uF 16V; C_0805_2012Metric; MPN CL21A475KAQNNNE; LCSC C1779
C201: 100nF 16V; C_0402_1005Metric; MPN CL05B104KO5NNNC; LCSC C1525
C202: 1uF 25V; C_0805_2012Metric; MPN CL21B105KBFNNNE; LCSC C28323
D200, D201: H5VUT2U; SOT-23; MPN H5VUT2U; LCSC C20615824
F200: 3A 32V 0467003.NRHF; Fuse_0603_1608Metric; MPN 0467003.NRHF; LCSC C99558
J200: USB4105-GF-A; USB_C_Receptacle_GCT_USB4105-xx-A_16P_TopMnt_Horizontal; MPN USB4105-GF-A; LCSC C3020560
J400: UART / CONTROL / 5V IN; HCTL_PM254-2-06-S-8.5; MPN PM254-2-06-S-8.5; LCSC C3975151
J401: SPI / DATA; HCTL_PM254-2-05-S-8.5; MPN PM254-2-05-S-8.5; LCSC C3975150
Q402: MMBT3904; SOT-23; MPN MMBT3904; LCSC C20526
R200: 24kR; R_0402_1005Metric; MPN 0402WGF2402TCE; LCSC C25769
R201: 47kR; R_0402_1005Metric; MPN 0402WGF4702TCE; LCSC C25792
R202: 4.7kR; R_0402_1005Metric; MPN 0402WGF4701TCE; LCSC C25900
R205, R206, R402, R403, R414: 100kR; R_0402_1005Metric; MPN 0402WGF1003TCE; LCSC C25741
R208, R410, R417: 1kR; R_0402_1005Metric; MPN 0402WGF1001TCE; LCSC C11702
R209: 100R; R_0402_1005Metric; MPN 0402WGF1000TCE; LCSC C25076
R404, R413, R416: 10kR; R_0402_1005Metric; MPN 0402WGF1002TCE; LCSC C25744
R407, R408, R409, R415: 22R; R_0402_1005Metric; MPN 0402WGF220JTCE; LCSC C25092
SW400: RESET; XKB_TS-1187A-B-A-B_5.1x5.1mm; MPN TS-1187A-B-A-B; LCSC C318884
SW401: BOOT; XKB_TS-1187A-B-A-B_5.1x5.1mm; MPN TS-1187A-B-A-B; LCSC C318884
U200: CP2105-F01-GMR; QFN-24-1EP_4x4mm_P0.5mm_EP2.7x2.6mm; MPN CP2105-F01-GMR; LCSC C109102

Connections:
3V3_R: R205.1, R206.1, R404.1, R416.1, SW401.1; also elsewhere on the board
AOP_DATA_TX: J401.9, R206.2, U200.20 (RXD_SCI); also elsewhere on the board
AOP_HOST_INTR: J401.7; also elsewhere on the board
AOP_NERROR_OUT: J400.6; also elsewhere on the board
AOP_NRESET: R417.2, SW400.1; also elsewhere on the board
AOP_SOP2: J400.5, R410.2; also elsewhere on the board
AOP_SPI_CLK: R402.1, R407.2; also elsewhere on the board
AOP_SPI_CS_N: R404.2, R409.2; also elsewhere on the board
AOP_SPI_MISO: J401.4; also elsewhere on the board
AOP_SPI_MOSI: R403.1, R408.2; also elsewhere on the board
AOP_SYNC_IN: R415.2; also elsewhere on the board
AOP_UART_RX: R208.2, R209.2, R416.2; also elsewhere on the board
AOP_UART_TX: J400.1, R205.2, U200.12 (RXD_ECI); also elsewhere on the board
FRAME_START: J401.8; also elsewhere on the board
GND: C200.2, C201.2, C202.2, C203.2, D200.3 (GND), D201.3 (GND), J200.A1 (GND), J200.A12 (GND), J200.B1 (GND), J200.B12 (GND), J200.SH (SHIELD), J400.4, J400.9, J400.10, J401.2, J401.6, J401.10, Q402.2 (E), R201.2, R402.2, R403.2, R414.2, SW400.2, U200.2 (GND), U200.10 (CTS_ECI), U200.18 (CTS_SCI), U200.25 (EP); also elsewhere on the board
HOST_DISABLE: J400.7, R413.1
HOST_NRESET: J400.8, R417.1
HOST_SPI_CLK: J401.1, R407.1
HOST_SPI_CS_N: J401.5, R409.1
HOST_SPI_MOSI: J401.3, R408.1
HOST_SYNC_IN: J400.3, R415.1
HOST_UART_TX: J400.2, R209.1
MANUAL_BOOT: R410.1, SW401.2
PMIC_ENABLE: Q402.3 (C); also elsewhere on the board
PWR_IN: J400.11, J400.12; also elsewhere on the board
Q402_BASE: Q402.1 (B), R413.2, R414.1
USB_3V45: C200.1, C201.1, R202.1, U200.5 (VIO), U200.6 (VDD)
USB_BRIDGE_RESET_N: R202.2, U200.9 (~RST)
USB_CC1: D201.1 (IO1), J200.A5 (CC1); also elsewhere on the board
USB_CC2: D201.2 (IO2), J200.B5 (CC2); also elsewhere on the board
USB_CONN_VBUS: F200.1, J200.A4 (VBUS), J200.A9 (VBUS), J200.B4 (VBUS), J200.B9 (VBUS)
USB_D+: D200.1 (IO1), J200.A6 (D+), J200.B6 (D+), U200.3 (D+)
USB_D-: D200.2 (IO2), J200.A7 (D-), J200.B7 (D-), U200.4 (D-)
USB_UART_TX: R208.1, U200.13 (TXD_ECI)
USB_VBUS: C202.1, F200.2, R200.1, U200.7 (REGIN); also elsewhere on the board
USB_VBUS_SENSE: R200.2, R201.1, U200.8 (VBUS)
USB_VPP: C203.1, U200.16 (VPP)

Notes on the sheet:
USB-C / ESD
CP2105 / ENHANCED CONTROL + STANDARD DATA
REAR CARRIER SOCKETS
J400: control/UART + 5V input. J401: SPI + telemetry. Rear sockets; pin1 at top.
UART / MODE DEFAULTS
R208 1k: limits bridge injection while radar is off. Carrier TX via R209 100R; USB unplugged. Stock CP2105 GPIO mode; ECI control/flash, SCI data RX.
SPI / SYNC DAMPING + DEFAULTS
BOOT / OPEN-DRAIN RESET / DISABLE
HOST_DISABLE: HIGH = rails off. HOST_NRESET: open-drain LOW only. BOOT released in carrier mode. Carrier pins Hi-Z while 3V3_R off.
USB OR carrier; never both. Shell = GND; ESD at receptacle.

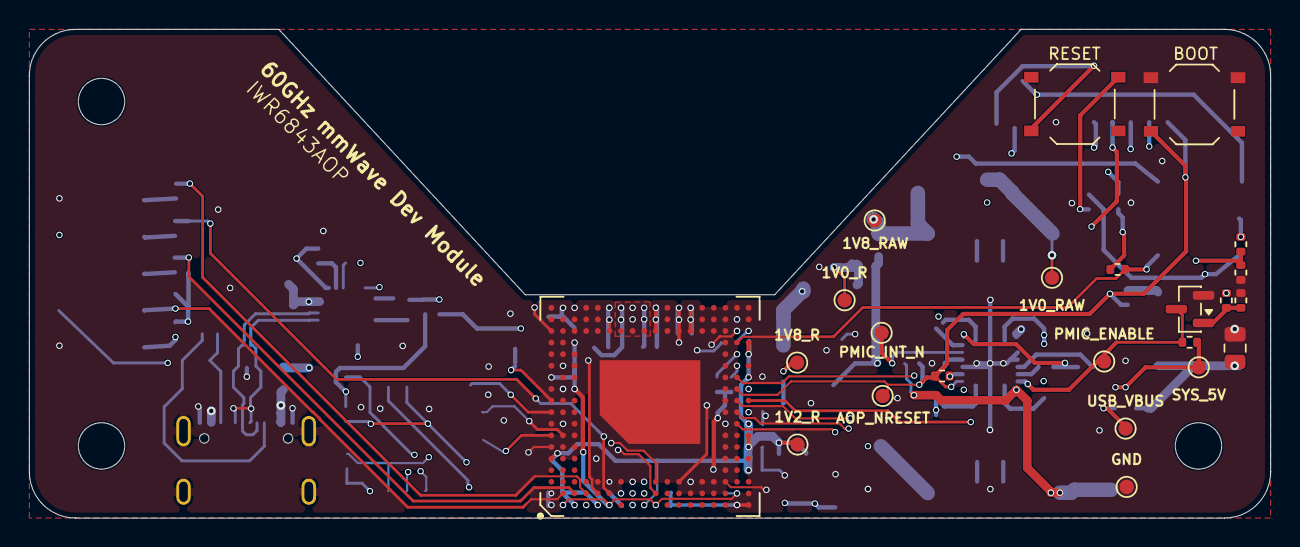
[picture p9: board IWR-AOP-MODULE.kicad_pcb from above]

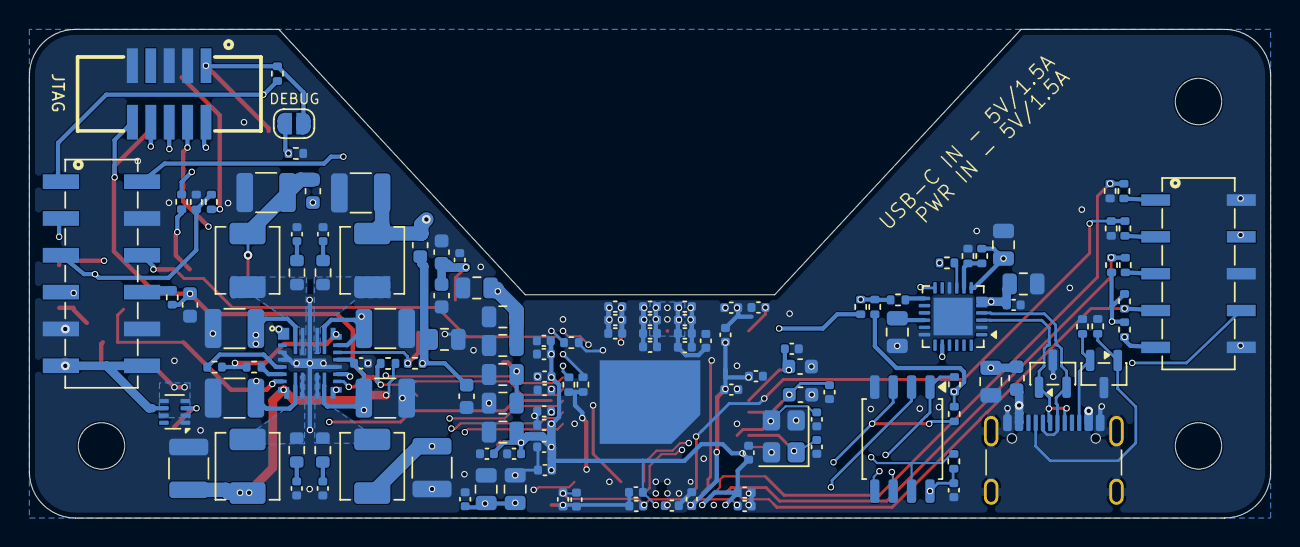
[picture p10: board IWR-AOP-MODULE.kicad_pcb from below]

Board: 6 copper layers, 85.6 x 33.7 mm, 158 parts (131 on the bottom side), 74 nets.

Other parts of the board:
H1, H3, H4: MountingHole_3.2mm_M3
TH300: AOP_ALP180_DieThermalPad

Their connections:
GND: TH300.1; also elsewhere on the board
